Tan-2004/ad9910-dds/(commit log)

2026-02-27 Added autoconverted Kicad files
    [ad9910-dds.kicad_pcb, ad9910-dds.kicad_sch, ad9910-dds_1.kicad_sch, ad9910-dds_2.kicad_sch]
2026-02-27 Check library links
    [ad9910-dds.kicad_pcb, ad9910-dds.kicad_sch, ad9910-dds_1.kicad_sch, ad9910-dds_2.kicad_sch]
